PubInv/optical-linear-sensor/index.md

---
layout: default
title: Optical Linear Sensor
---

<!-- Copyright Robert L. Read, 2017

// This file is part of optical-linear-sensor

//     Foobar is free software: you can redistribute it and/or modify
//     it under the terms of the GNU General Public License as published by
//     the Free Software Foundation, either version 3 of the License, or
//     (at your option) any later version.

//     Foobar is distributed in the hope that it will be useful,
//     but WITHOUT ANY WARRANTY; without even the implied warranty of
//     MERCHANTABILITY or FITNESS FOR A PARTICULAR PURPOSE.  See the
//     GNU General Public License for more details.

//     You should have received a copy of the GNU General Public License
//     along with color-block-font.  If not, see <http://www.gnu.org/licenses/>.

-->

<link rel="stylesheet" href="./stylesheets/color-block.css">

<style>
 .text-block {
    font-family: "Courier";
font-size: 22px;
text-align: left;
}
</style>
     
  <div id="content-wrapper">
    <div class="inner clearfix">
      <section id="main-content">
	<section id="textsection" style="{border: red;}">
	</section>

	  <h1> Motivation </h1>
<p>
As part of the GlussCon project, we needed linear position (or linear length) sensor.
We used slide potentiometers for this purpose.  However, these were limited in the sizes
that we were able to purchase. 
</p>
<p>
We are exploring the possibility of making linear position or length sensors based on using light that
may have a number of advantages. These advantages potentially include:
<ul>
<li>
Complete customizability of size
<li>
Possibility of 3D printing multiple connected units simultaneously
<li>
Possibly obtaining greater accuracy
<li>
Possibly obtaining greater performance in other ways
</ul>
</p>
<h1> experiments</h1>
<a href="https://github.com/PubInv/optical-linear-sensor/blob/master/experiments/Test%20Results%20from%20Existing%20Sensor.pdf"> First Experiment</a>.
<h3>
  <a id="authors-and-contributors" class="anchor" href="#authors-and-contributors" aria-hidden="true"><span aria-hidden="true" class="octicon octicon-link"></span></a>Authors and Contributors</h3>

<p><a href="https://github.com/PubInv/optical-linear-sensor">Optical Linear Sensor</a> is written and maintained by

  <a href="mailto:read.robert@gmail.com">Robert L. Read</a> at <a href="https://github.com/PubInv">PubInv</a>.</p>

<p> This is a newly created work, please send comments, ideas, or suggestions to Rob or open an issue.</p>

<p>Check out our parent project, <a href="https://pubinv.github.io/PubInv">Public Invention</a>.</p>
