PubInv/optical-linear-sensor/doc/figures/ExistingSensorDiagram.png

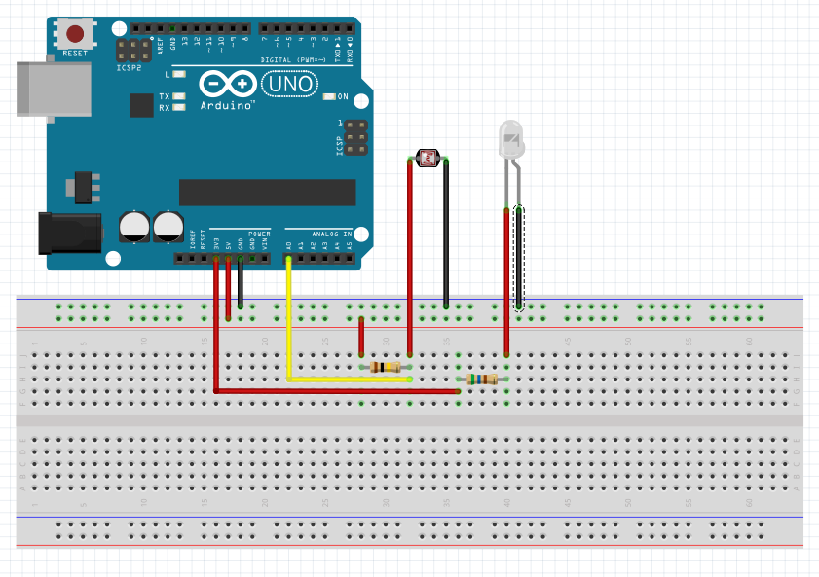
doc/figures/ExistingSensorDiagram.png
