PubInv/optical-linear-sensor/images/noun_196907.png

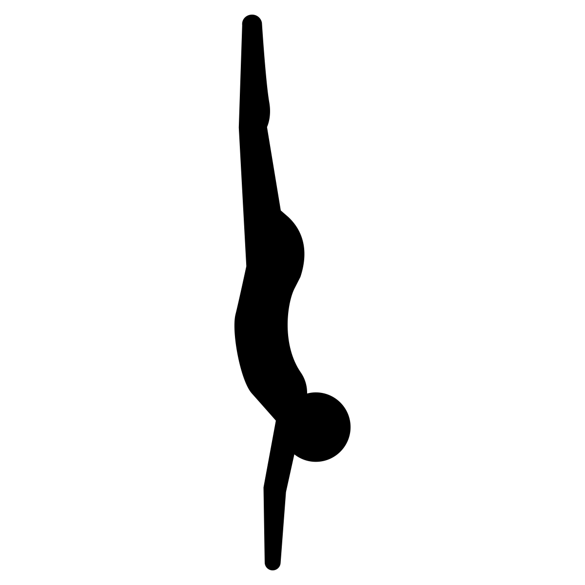
images/noun_196907.png
