PubInv/optical-linear-sensor/images/noun_308204_cc.png

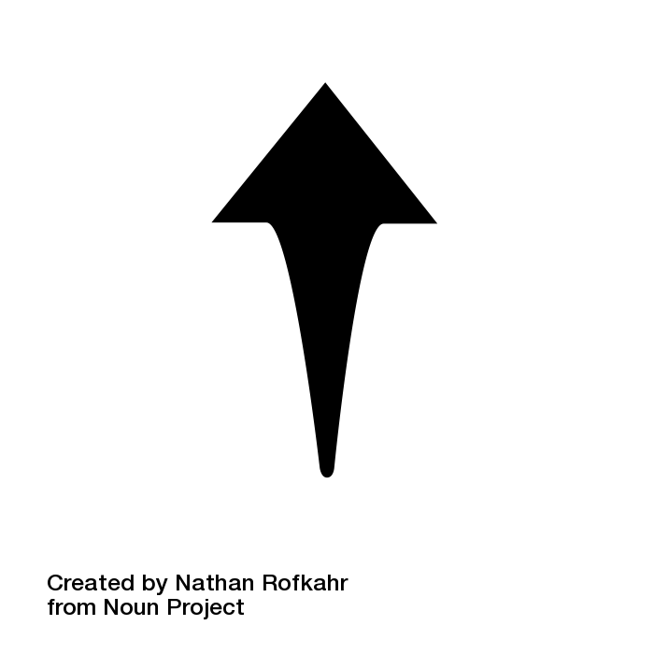
images/noun_308204_cc.png
