PubInv/optical-linear-sensor/experiments/Test Results from Existing Sensor.pdf

Keeshan Patel
June 4th, 2017

Test Results from Existing Sensor (Mark I) The existing structure consisted of a clear plastic tube wrapped in blue electrical tape and in construction paper in order to prevent light from escaping and entering the chamber. A CdS photoresistor (photocell) was attached to a 100K resistor in series and a 5 volts source and a white LED was attached to a 560 resistor in series a 3.3 V source. The photocell was placed in a 1 cm black tubing and both the photocell housing and the LED were placed at one end of the plastic tubing and black electrical tape was used to secure them and to prevent light from entering the tube. A 1 cm black rode with 2 white caps on either ends was placed in a 3D printed sliding holster so it could slide back and forth from end to end.

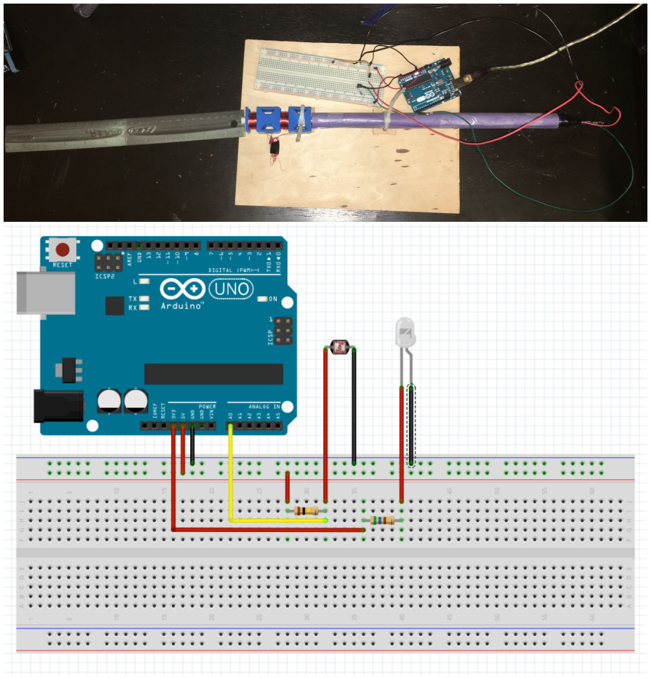
[picture p15: figure]

The procedure was to wire the LED, photocell, and resistor to the Arduino. A simple Arduino script was used to sample the photocell’s voltage divider once every second. The ADC value from the serial output of the Arduino was recorded for every 1 centimeter from 0 cm to 26 cm.
The results of the experiment were recorded in an excel sheet. Since the Arduino uses a 12 bit ADC, the output of the serial reading range from 0 to 1023. The equation [(measurement)/1023 * 5] was used to map the ADC value to a voltage. The results are shown below.

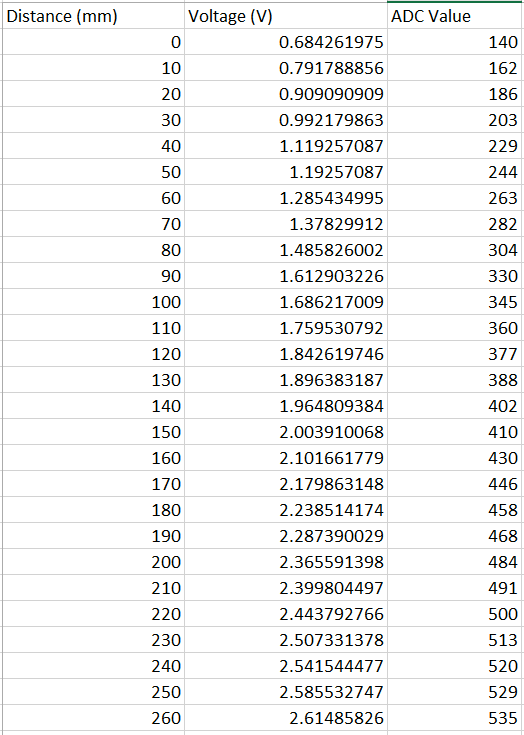
[picture p16: figure]

The results were plotted on a scatter plot for Distance (millimeters) vs Voltage (volts). Three regressions were used to analyze the data: linear, polynomial (degree 2), and logarithmic. The equation of the regression line as well as the R squared value are shown on the linear regression plots below. Also, a forecast of 750 mm was plotted to see if the regression would be an accurate representation of a greater distance.

### Linear Sensor Plot

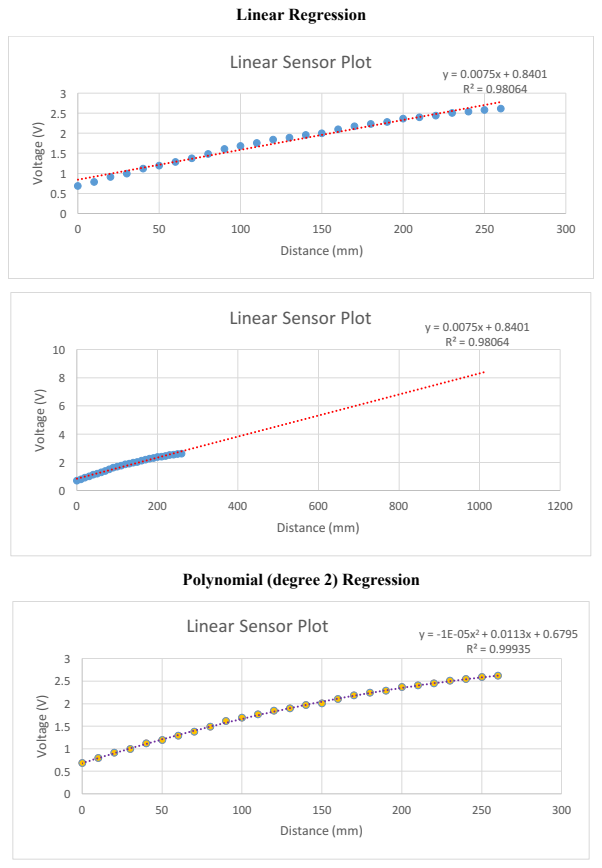
[picture p17: page 3]
Linear Regression; Voltage (V); Distance (mm)

Linear Sensor Plot

Polynomial (degree 2) Regression

### Linear Sensor Plot

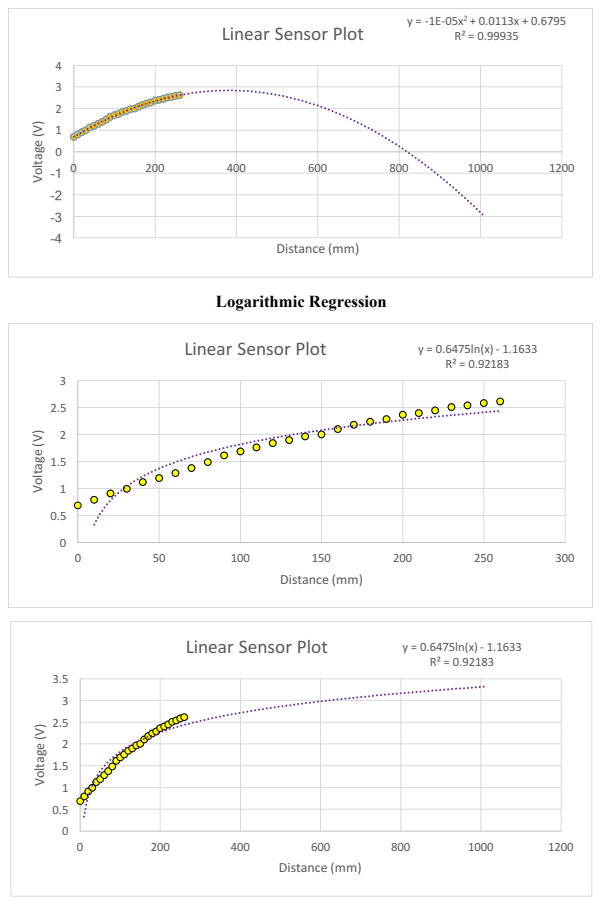
[picture p18: page 4]
Voltage (V); Distance (mm)

Logarithmic Regression
Linear Sensor Plot

### Analysis

The linear regression was a good fit with a 0.9806 R-squared value, the linear regression plot would continue to infinity. A linear regression would be accurate for small distances.
The polynomial regression had the best R-squared value of 0.9993, the forecast plot goes to negative infinity.
The logarithmic regression had the worst R-squared value with 0.9218, but its forecast would theoretically be the most accurate.

### Conclusion

The photocell accurately changed resistance based on the rod’s distance from the LED. The polynomial regression was the best fit line, but more test data needs to be taken where the light fades so that the regression line can be more accurate. The existing sensor gave great results for optical distance sensing. For future design, a completely black rod could be used to avoid wrapping the tube and a tighter seal on the sliding tube and outer tube could yield better results. Depending on different sized tubes and different rod lengths, the equation of voltage vs distance could change, but there is a clear relation with the existing sensor that is built.
