PubInv/optical-linear-sensor/(notices)

Notices in the files:
doc/OpticalDisplacementSensor.tex:
This work is distributed under the LaTeX Project Public License (LPPL)
